linhz0hz/CH32V307RCT6_breakout_hz/(commit log)

2022-08-15 Found out that the USB D+/- was connected wrong on both connectors. Corrrecting that on the board.
    [CH32V307_RCT6.kicad_pcb, MCU_Core.kicad_sch]
2022-08-26 Add pull-up resistors for SD card slot
    [CH32V307_RCT6.kicad_pcb, CH32V307_RCT6.kicad_sch, MCU_Core.kicad_sch]
2022-08-27 Change boot0 to a button. Also add a few spike supression / impedance matching resistors to some pins that could be used for generating correct edges
    [CH32V307_RCT6.kicad_pcb, CH32V307_RCT6.kicad_sch, MCU_Core.kicad_sch]
2022-08-27 Move sd card holder closer to the edge, and added breakout pins for SDIO signals.
    [CH32V307_RCT6.kicad_pcb, CH32V307_RCT6.kicad_sch, MCU_Core.kicad_sch]
2022-08-27 Add more spike control resistors. And generate new gerbers
    [CH32V307_RCT6.kicad_pcb, CH32V307_RCT6.kicad_sch, MCU_Core.kicad_sch, bom.csv, designators.csv, positions.csv]
2022-09-09 Pre-fab fix
    [CH32V307_RCT6.kicad_pcb, CH32V307_RCT6.kicad_sch, MCU_Core.kicad_sch]
2023-01-29 Commit current version, unsure what changed, probably nothing major
    [CH32V307_RCT6.kicad_pcb, CH32V307_RCT6.kicad_sch, MCU_Core.kicad_sch, bom.csv, designators.csv, positions.csv]
